patmakesapps/Wrist-Wearable-Project/reference/rover-parts-layout.jpg

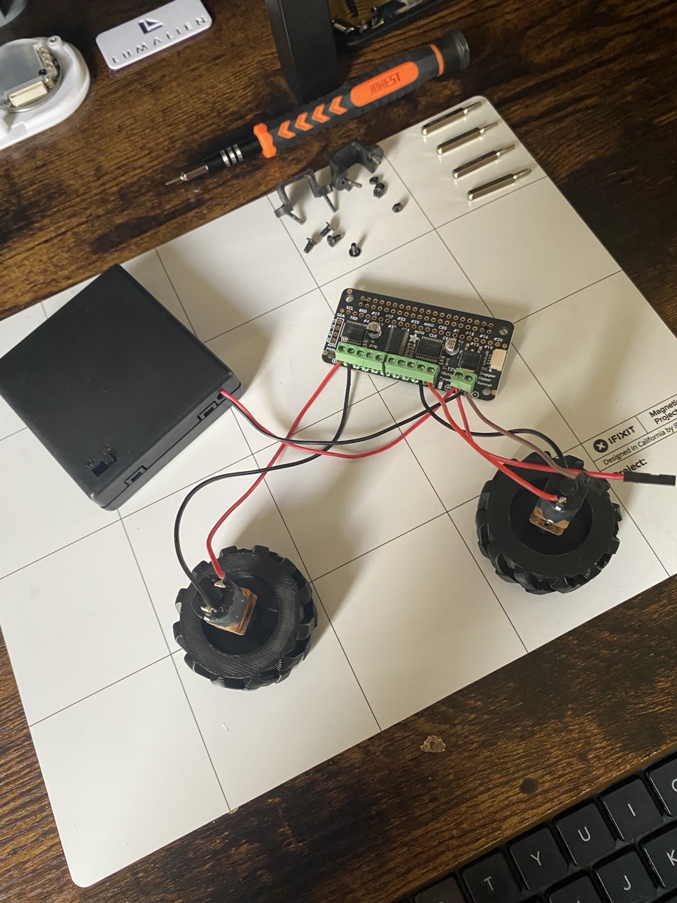
reference/rover-parts-layout.jpg
