patmakesapps/Wrist-Wearable-Project/reference/esp32-devkit-30pin.jpg

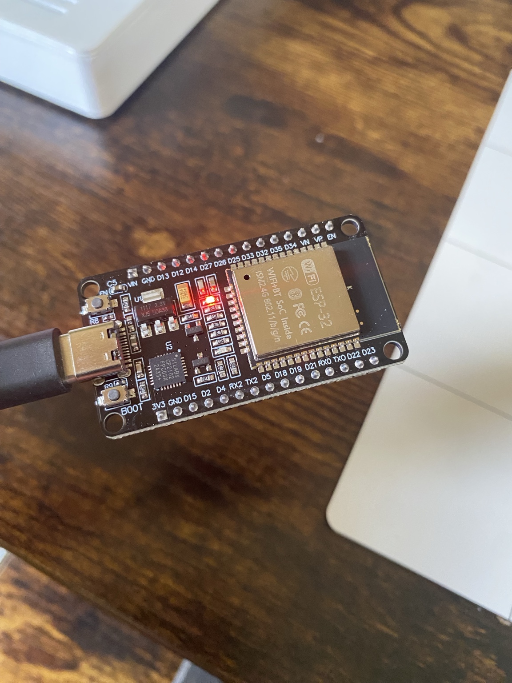
reference/esp32-devkit-30pin.jpg
