patmakesapps/Wrist-Wearable-Project/README.md

# Wrist-Controlled Rover

Tilt your hand, the rover drives. Two ESP32s talking over ESP-NOW (direct radio, no router):

- **Controller** (the wearable): ESP32 DevKit + GY-521 MPU6050 + 5 V vibration motor module.
  Hand tilt becomes throttle and steering; the motor gives haptic confirmation and warnings.
- **Rover**: a second ESP32 DevKit + Adafruit DC/Stepper Motor Bonnet + two N20 gear motors,
  inside a 3D-printed hull.

Arduino framework on PlatformIO (pioarduino espressif32 platform, Arduino core 3.x). No external libraries.

## Wiring (all solderless jumper wires)

### Controller

| Device | Pin | ESP32 |
|---|---|---|
| Motor module | IN | GPIO25 |
| Motor module | VCC | VIN (5 V from USB) |
| Motor module | GND | GND |
| MPU6050 | VCC | 3V3 |
| MPU6050 | GND | GND |
| MPU6050 | SDA | GPIO21 |
| MPU6050 | SCL | GPIO22 |

MPU6050 AD0 left open, so the I2C address is 0x68. This particular GY-521 reports WHO_AM_I 0x74 (clone die, works fine).

### Rover

The bonnet is a Pi HAT, but it is just an I2C device. Male-to-male jumpers from the ESP32 into the bonnet's
2x20 female header. Pin 1 is the square-marked corner pin; odd pins are on that row.

| Bonnet | Pin | ESP32 |
|---|---|---|
| 3V3 (logic) | header pin 1 | 3V3 |
| SDA | header pin 3 | GPIO21 |
| SCL | header pin 5 | GPIO22 |
| GND | header pin 6 | GND |
| Motor power + / - | screw terminal | bench: ESP32 VIN / GND. Mobile: 4xAA pack or a USB power bank feeding the ESP32, then VIN -> terminal |
| Left motor | M1 terminals | |
| Right motor | M4 terminals | |

Which of a motor's two wires goes in which hole doesn't matter: if a wheel runs backwards, flip its sign in `config.h`.

The ESP32's internal pull-ups are the only I2C pull-ups on that bus, so the rover runs I2C at 100 kHz.
If the whole thing drives mirrored, swap the `MOTOR_LEFT` / `MOTOR_RIGHT` terminal numbers.

#### Rover on the Waveshare ESP32-S3-LCD-1.47 instead

Same bonnet wiring, but SDA goes to **GPIO4** and SCL to **GPIO5** (GPIO21 is the TF card on that board,
38 to 48 are the LCD and RGB LED). Use the `*_s3` environments.

The board is a USB-A stick. With the USB plug pointing up and the screen facing you, the left column of
pins reads, top to bottom: `5V, GND, 3V3, 1, 2, 3, 4, 5, 6`. The right column: `TX, RX, 13, 12, 11, 10, 9, 8, 7`.
Pinout: https://www.waveshare.com/wiki/ESP32-S3-LCD-1.47

| S3 board pin | Bonnet header pin |
|---|---|
| 3V3 (3rd from top, left) | 1 (3V3) |
| 4 (7th from top, left) | 3 (SDA) |
| 5 (8th from top, left) | 5 (SCL) |
| GND (2nd from top, left) | 6 (GND) |

Power the S3 board through its USB plug only: the PC while testing, a USB power bank in the hull later
(it plugs straight into the bank's USB-A socket). Do not feed the AA pack into its 5V pin: that pin is the USB
line itself. The AA pack feeds the bonnet's motor terminal, and the GND jumper above already ties the
battery, bonnet and board to one ground, so no separate wire from the battery terminal to the board is needed.

## Layout

```
platformio.ini             one env per bring-up stage, plus controller / rover / standalone
flash.ps1                  Windows wrapper: .\flash.ps1 <env> [-Port COMx] [-Monitor]
include/config.h           every pin, threshold, rate and sign, in one place
include/packets.h          ESP-NOW wire format (control, telemetry, heartbeat)
include/link.h    src/link.cpp      ESP-NOW wrapper (latest-packet mailbox)
include/imu.h     src/imu.cpp       MPU6050 register driver + tilt helpers
include/haptics.h src/haptics.cpp   PWM vibration motor + pattern player
include/bonnet.h  src/bonnet.cpp    PCA9685/TB6612 motor bonnet driver
include/motion.h  src/motion.cpp    threshold detector (standalone demo only)
src/controller/main.cpp    wearable firmware
src/rover/main.cpp         rover firmware
src/standalone/main.cpp    original motion -> buzz demo, no radio
src/stages/01..05          bring-up tests (see below)
```

## Bring-up, in order

```
.\flash.ps1 stage1_i2c_scan                 controller: SDA/SCL idle high, device at 0x68
.\flash.ps1 stage2_imu_stream               controller: |a| ~1.00 g at rest, tilt follows the board
.\flash.ps1 stage3_motor                    controller: three buzzes, intensity sweep, patterns
.\flash.ps1 stage4_espnow_link              BOTH boards (second one with -Port COMx): each prints
                                            its MAC and the other's heartbeats with RSSI
.\flash.ps1 stage5_bonnet_test -Port COMx   rover: I2C scan shows 0x60 (+0x70 all-call), then
                                            left (M1) and right (M4) forward, reverse, ramp
.\flash.ps1 controller                      wearable firmware
.\flash.ps1 rover -Port COMx                rover firmware (runs without the bonnet for link tests)
```

For the Waveshare S3 board use `stage4_espnow_link_s3`, `stage5_bonnet_test_s3` and `rover_s3`. It enumerates
as "USB Serial Device" (native USB), COM6 on the bench PC.

Verified 2026-10-12: controller on COM3 and `rover_s3` on COM6 find each other over ESP-NOW within a second of
boot, and the rover's 300 ms command-timeout stop works when the controller drops out.

Add `-Monitor` to any line to open the serial monitor afterwards (Ctrl+C to exit), or run `pio device monitor --port COMx`.

Stages 1 to 3 were verified on the bench on 2026-10-12. Stages 4 and 5 need the second board plugged in.

## Driving

1. Power both. The controller double-taps on boot; its status line shows `rover none` until the rover answers.
2. Hold your hand still, in whatever pose you want to mean "stop", for 1 s. Single tap = **armed**, and that
   pose is now neutral. No need for the sensor to be level.
3. Tilt forward/back for throttle, roll left/right to steer. Dead zone 8 degrees, full speed at 35.
4. **Sharp shake = e-stop.** Double tap, rover halts immediately, re-arm possible after 1.5 s by holding still again.
5. If the rover stops answering while armed, the controller gives a long buzz every 2 s. The rover also stops
   itself after 300 ms without commands, so a dead controller never leaves it driving.

`z` in the monitor re-zeros without re-arming, if you ever want that.

Controller serial keys: `a` arm, `d` disarm, `z` zero tilt, `s` status stream, `b` buzz, `c` gyro recal, `?` help.

## Droid chassis (3D print)

Blender source: `cad/Wrist controlled Droid.blend` (hardware fit models appended from the Lumalien MASTER HARDWARE
library). Printable parts in `cad/stl/`:

| Part | Size | Orientation | Supports |
|---|---|---|---|
| `droid_chassis_v1.stl` | 79 x 106 x 41.5 mm | flat bottom down | none, except optionally inside the caster pocket under the nose (32 mm bridge) |
| `droid_deck_v1.stl` | 80 x 76 x 13.5 mm | flat side down, pillars up | none |

Layout, rear to front: the two N20s sit on the plate in their bridge brackets with the shafts out through windows in
the side walls (43 mm wheels put the axle at 21.5 mm, so the plate top is at 16.5 mm). The 4xAA case drops in over
the motors, switch end forward. The deck screws onto the wall flanges and carries the motor bonnet at the rear,
terminals facing back, and the ESP32 on four 9 mm pillars so its header pins hang free. The Marrteum ball caster
sits in the pocket under the nose, flat base against the pocket ceiling, ball out the bottom.

Screws, all self-tapping into plastic: 4 x M3x6 (brackets), 2 x M2.5x6 (caster, 22 mm apart), 4 x M2.5x6 (deck to
flanges), 4 x M2.5x6 (bonnet to standoffs, 58 x 23 mm pattern), 2 zip ties (ESP32 over the pillars, through the deck
slots).

Assembly: brackets and motors onto the plate, wheels on, caster into the nose pocket, AA case in, deck on, then the
bonnet and ESP32 on the deck. Motor leads drop through the notch at the rear of the deck; battery leads come up
through the slot at the front of the deck.

## Hood (3D print, cosmetic)

| Part | Size | Orientation | Supports |
|---|---|---|---|
| `droid_hood_v1.stl` | 86 x 94 x 50 mm | exported flat top down, print as-is | none |

The hood drops over the deck with no screws: internal rests sit on the deck top, the rear wall locates against the
deck's rear edge and two stops catch its front edge. Wheel arches clear the tires, the front below the deck line is
open so the nose and the AA switch stay reachable, and a port on the left side lines up with the ESP32's USB-C. Two
eye recesses on the face slope are there for paint.

## Hand controller (3D print)

Same Blender file, parts in `cad/stl/`:

| Part | Size | Orientation | Supports |
|---|---|---|---|
| `controller_base_v1.stl` | 96 x 62 x 24 mm | open side up | none |
| `controller_lid_v1.stl` | 96 x 62 x 4 mm | flat outer face down | none |

Inside the base: the ESP32 DevKit sits on four 15 mm pillars with L stops, component side up, USB-C toward the
end wall with the cable slot. The 15 mm leaves room for the dupont jumpers plugged onto the downward header pins.
The GY-521 lies flat in a 21 x 16 mm locating frame, long axis along the controller, and the vibration module in a
24 x 20 mm frame beside it where the palm sits. Both frames are open on the wire side and have zip-tie slots either
side; double-sided tape also works. Two 4 x 40 mm slots through the floor take a hand strap. The lid has a locating
rim and screws into the four corner bosses with M2.5x8 self-tappers. ESP32 is held by two zip ties over the board.

Assumed footprints, measure yours if they differ: DevKit 52 x 28.5 mm, GY-521 21 x 16 mm, vibration module
24 x 20 mm.

## Tuning

Everything lives in `include/config.h`:

| Setting | What it does |
|---|---|
| `TILT_DEADZONE_DEG`, `TILT_FULL_DEG` | how much tilt before it moves, and where 100 % is |
| `PITCH_SIGN`, `ROLL_SIGN` | flip if forward or left feel reversed |
| `ARM_HOLD_MS`, `ESTOP_SHAKE_G` | arm hold time, shake strength that disarms |
| `MOTOR_MIN_PERCENT` | lowest duty the N20s actually turn at |
| `MOTOR_SLEW_PER_TICK` | acceleration limit, protects the gearboxes |
| `CMD_TIMEOUT_MS` | rover self-stop when commands vanish |

## Troubleshooting

- **No COM port**: the DevKits use a Silicon Labs CP210x bridge. Windows normally has the driver.
- **Upload times out**: hold BOOT while esptool says `Connecting...`, or lower `upload_speed` to 460800.
- **`UnicodeEncodeError` during upload**: esptool's progress bar vs. the Windows console code page. The flash still completes. `flash.ps1` sets UTF-8 first; or run `setx PYTHONUTF8 1` once.
- **Stage 4 sees no heartbeats**: both boards must be in STA mode on the same channel; this firmware never joins Wi-Fi, so both sit on channel 1. Check that the second board is a classic ESP32 (an S3/C3 needs a different `board` in `platformio.ini`).
- **Stage 5 finds nothing at 0x60**: re-check pin 1 (3V3) and pin 6 (GND). If the scan is flaky, add two 4.7 k pull-ups on SDA/SCL via a breadboard.
- **Motors twitch but don't turn**: motor power terminal not powered, or `MOTOR_MIN_PERCENT` too low.
- **WHO_AM_I not 0x68**: clone die. Same register map; nothing to fix.
