patmakesapps/Wrist-Wearable-Project/reference/motor-bonnet-wired.jpg

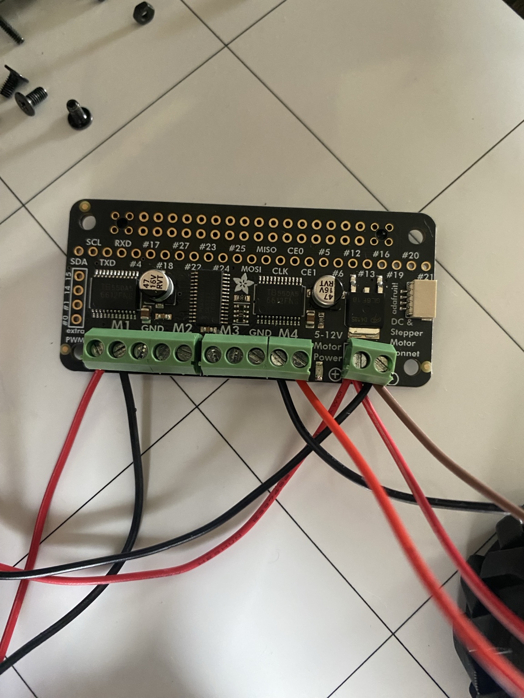
reference/motor-bonnet-wired.jpg
