patmakesapps/Wrist-Wearable-Project/cad/stl/controller_base_v1.stl

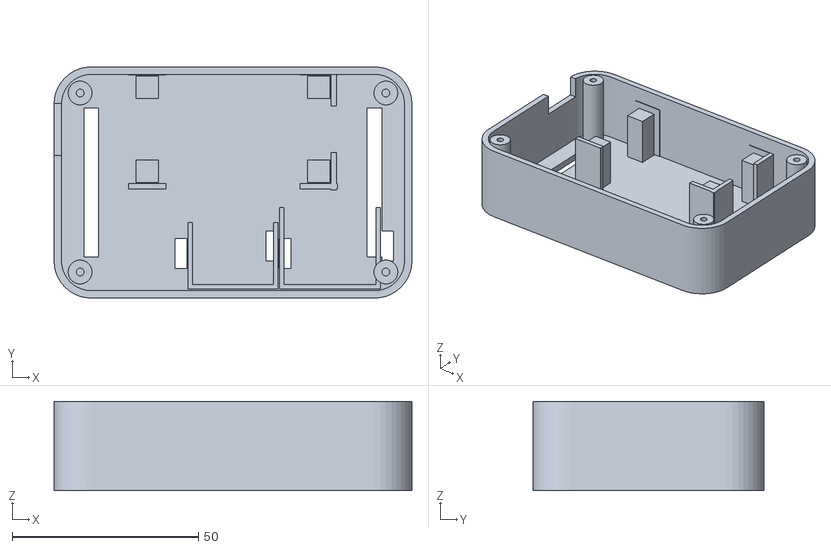
[picture p4: CAD file, 2026-10-12]
cad/stl/controller_base_v1.stl
96.0 x 62.0 x 24.0
