patmakesapps/Wrist-Wearable-Project/cad/stl/droid_deck_v1.stl

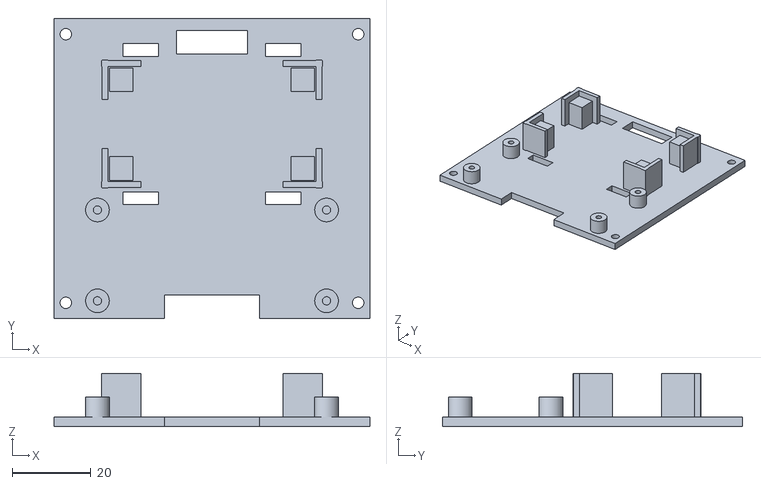
[picture p5: CAD file, 2026-10-12]
cad/stl/droid_deck_v1.stl
80.0 x 76.0 x 13.5
