patmakesapps/Wrist-Wearable-Project/cad/stl/controller_lid_v1.stl

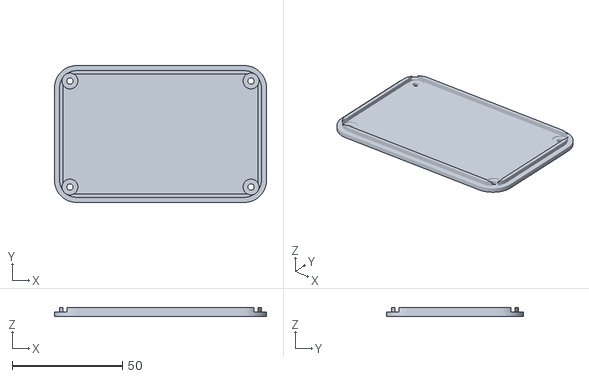
[picture p6: CAD file, 2026-10-12]
cad/stl/controller_lid_v1.stl
96.0 x 62.0 x 4.00
