patmakesapps/Wrist-Wearable-Project/cad/stl/droid_chassis_v1.stl

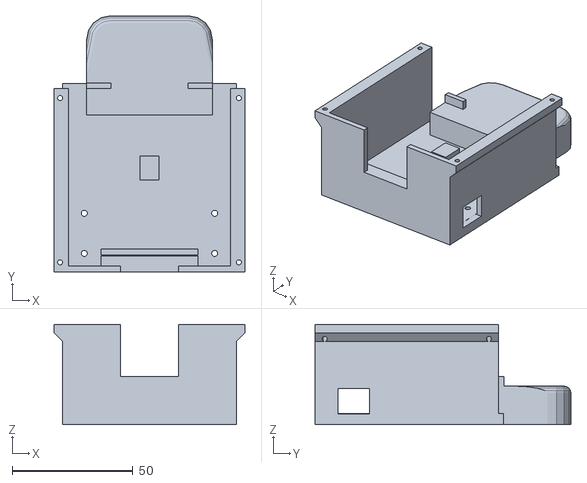
[picture p7: CAD file, 2026-10-12]
cad/stl/droid_chassis_v1.stl
79.0 x 106.0 x 41.5
