patmakesapps/Wrist-Wearable-Project/cad/stl/droid_hood_v1.stl

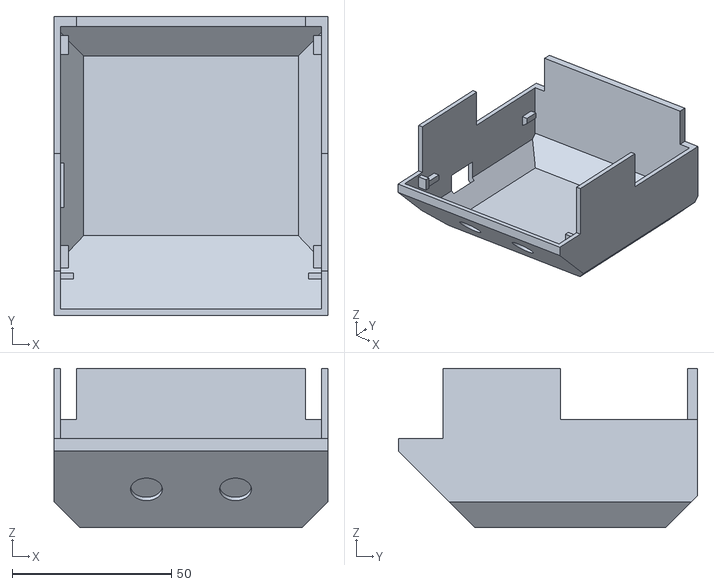
[picture p8: CAD file, 2026-10-12]
cad/stl/droid_hood_v1.stl
86.0 x 94.0 x 50.0
