patmakesapps/Wrist-Wearable-Project/(list of files, cad)

Other CAD files:
cad/Wrist controlled Droid.blend
