patmakesapps/Wrist-Wearable-Project/(commit log)

2026-10-12 Wrist-controlled rover: controller, rover, and staged bring-up
    ESP32 wearable (MPU6050 + vibration motor) sends hand tilt over ESP-NOW
    to a rover ESP32 driving two N20s through an Adafruit Motor Bonnet.
    Includes five bring-up stages, the original stand-alone motion-to-buzz
    demo, a Waveshare ESP32-S3-LCD-1.47 build target, and a Windows flash
    wrapper.
    [01_i2c_scan.cpp, 02_imu_stream.cpp, 03_motor_pulse.cpp, 04_espnow_link.cpp, 05_bonnet_test.cpp, bonnet.cpp, bonnet.h, config.h]
2026-10-12 Add Waveshare ESP32-S3-LCD-1.47 rover target
    Per-board I2C pins in config.h (GPIO4/5 on the S3 board), s3lcd build
    base with native-USB CDC flags, and *_s3 environments for the link test,
    bonnet test and rover firmware. README covers wiring and power for it.
2026-10-12 Motors on bonnet terminals M1 (left) and M4 (right)
2026-10-12 README: exact S3 header pins for the bonnet, USB-A power note, link verified
2026-10-12 Add reference photos: DevKit pinout, motor bonnet wiring, rover parts
2026-10-12 Rover: right motor sign flipped, bench motor keys, lower radio TX power, lock to first peer
    [config.h, link.cpp, main.cpp]
2026-10-12 Controller: arm by holding still in any pose, which becomes neutral
2026-10-12 CAD: droid chassis and deck v1 (Blender source + STLs)
    Stacked layout: N20s in bridge brackets at the rear, 43 mm wheels, AA case
    over the motors, bonnet + ESP32 deck on top. Marrteum ball caster mounts
    under a raised nose with its own M2.5 holes. Flat-bottom print.
    [Wrist controlled Droid.blend, droid_chassis_v1.stl, droid_deck_v1.stl]
2026-10-12 README: chassis print and assembly notes; ignore Blender backups
2026-10-12 CAD: hand controller base and lid v1; README notes
    [Wrist controlled Droid.blend, controller_base_v1.stl, controller_lid_v1.stl]
2026-10-12 CAD: smooth-by-angle shading on all meshes
    [Wrist controlled Droid.blend]
2026-10-12 CAD: drop-on hood with face slope, wheel arches, USB port, and two glue-on blaster guns
    [Wrist controlled Droid.blend, droid_gun_L_v1.stl, droid_gun_R_v1.stl, droid_hood_v1.stl]
2026-10-12 Hood and guns exported in print orientation; README notes
    [droid_gun_L_v1.stl, droid_gun_R_v1.stl, droid_hood_v1.stl]
2026-10-12 CAD: rounded nose on the chassis, bevelled gun receivers and pads
    [Wrist controlled Droid.blend, droid_chassis_v1.stl, droid_gun_L_v1.stl, droid_gun_R_v1.stl]
2026-10-12 CAD: gun bores and vent holes
    [Wrist controlled Droid.blend, droid_gun_L_v1.stl, droid_gun_R_v1.stl]
2026-10-12 CAD: 6 mm muzzle counterbore on both guns
    [Wrist controlled Droid.blend, droid_gun_L_v1.stl, droid_gun_R_v1.stl]
2026-10-12 Drop the gun parts
    [Wrist controlled Droid.blend, droid_gun_L_v1.stl, droid_gun_R_v1.stl]
2026-10-12 CAD: chassis STL re-exported with the hand-bevelled nose
    [Wrist controlled Droid.blend, droid_chassis_v1.stl]
2026-10-12 CAD: all five STLs re-exported from the current scene, print-oriented
    [Wrist controlled Droid.blend, controller_base_v1.stl, controller_lid_v1.stl, droid_chassis_v1.stl, droid_deck_v1.stl]
